young-nights/bluetooth_42_stepper_motor_balance_car/Diy-code_balance-car_ver1.0/docs/hardware-spec.md

# 42步进电机平衡车 — 硬件参数规格

> **项目**：Bluetooth 42 Stepper Motor Balance Car (蓝牙42步进电机平衡车)
>
> **版本**：Ver 1.0
>
> **文档日期**：2025-05-25

---

## 1. MCU 主控

| 参数 | 值 |
|---|-----|
| 型号 | STM32F103RCT6 |
| 内核 | ARM Cortex-M3 |
| 主频 | 72 MHz |
| Flash | 256 KB |
| SRAM | 48 KB |
| 封装 | LQFP64 |

---

## 2. IMU 惯性测量单元

| 参数 | 值 |
|---|-----|
| 型号 | MPU6050（InvenSense） |
| 通信接口 | I2C（软件模拟/硬件） |
| 姿态解算方法 | 互补滤波 |
| 滤波系数 α | 0.96（陀螺仪权重 96%，加速度计 4%） |
| 加速度计量程 | ±2g |
| 陀螺仪量程 | ±2000°/s |
| 姿态采样率 | 100 Hz（10ms 周期） |
| 俯仰角分辨率 | 0.01° |
| 机械中值 | 0.36° |

---

## 3. 电机

| 参数 | 值 |
|---|-----|
| 型号 | 42 步进电机 A0022 |
| 相数 | 2 相 |
| 步距角 | 1.8°（200 步/转） |
| 额定电压 | 3.0V |
| 额定电流 | 1.5A / 相 |
| 相电阻 | 2.0Ω（20°C） |
| 相电感 | 5.6mH（1kHz） |
| 保持力矩 | 0.40 N·m |
| 最大转速 | 800 RPM |
| 转子惯量 | 38 g·cm² |
| 重量 | 286.3g |
| 出轴直径 | 5mm |
| 机座尺寸 | NEMA17（42×42mm） |

---

## 4. 电机驱动

| 参数 | 值 |
|---|-----|
| 型号 | DRV8825（TI） |
| 工作模式 | 16 细分 + 混合衰减模式 |
| 最大驱动电流 | 2.5A / 相（峰值） |
| PWM 输出通道 | 左电机：TIM3_CH3 (PB0)；右电机：TIM3_CH4 (PB1) |
| PWM 频率 | 20 kHz |
| 使能引脚 | 通用 GPIO |
| 方向控制 | STEP/DIR 模式 |

---

## 5. 车轮

| 参数 | 值 |
|---|-----|
| 直径 | 65mm |
| 周长 | 204mm（π×65mm） |
| 材质 | 橡胶轮胎 |

---

## 6. 控制系统

| 参数 | 值 |
|---|-----|
| 控制架构 | 直立 PD + 速度 PI 串级控制 |
| 控制周期 | 5ms（200 Hz） |
| 姿态更新周期 | 10ms（100 Hz），MPU6050 数据读取 |
| 线程优先级 | 20 |
| 线程栈大小 | 4096 字节 |
| OS | RT-Thread v4.x |

---

## 7. PID 参数

| 控制环 | 参数 | 当前值 | 说明 |
|---|---|---|---|
| **直立环** | Kp | 15.0 | 比例增益 |
| | Ki | 0 | 不使用积分项 |
| | Kd | 4.0 | 微分阻尼（抑制高频振荡） |
| | 输出限幅 | ±1300 | 占空比限幅 |
| **速度环** | Kp | 0（已禁用） | 加速度计积分估算速度噪声过大 |
| | Ki | 0（已禁用） | 暂未启用，待编码器方案 |

> **注意**：速度环当前已禁用（Kp=0, Ki=0），因为速度估算基于 MPU6050 加速度计积分，
> 在无编码器的步进电机系统中，积分漂移噪声过大，会干扰直立环调试。
> 建议后续加装编码器后再重新启用速度环。

---

## 8. 蓝牙通信

| 参数 | 值 |
|---|-----|
| 模块接口 | UART2（115200bps，8N1） |
| 蓝牙模式 | SPP（串口透传） |
| UUID | 00001101-0000-1000-8000-00805F9B34FB |
| 设备名 | BalanceCar |
| 协议 | 自定义帧格式（Header 0x55AA / CRC16 Modbus） |

---

## 9. 电源

| 参数 | 值 |
|---|-----|
| 电池类型 | 锂电池组 |
| 电机供电 | 12V（经 DRV8825 直接驱动） |
| MCU 供电 | 3.3V（LDO 稳压） |
| MPU6050 供电 | 3.3V |

---

## 10. 机械参数

| 参数 | 值 |
|---|-----|
| 轴距（轮距） | ~150mm |
| 重心高度 | ~50mm（电池底部附近） |
| 总重量（含电池） | ~800g |

---

*文档维护：平衡车项目组 | 最后更新：2025-05-25*
