young-nights/bluetooth_42_stepper_motor_balance_car/2.Protolcal/通讯协议.docx

通讯协议

Balance Car

平衡小车

编制：xxx

版本号：V1.0

# 1 版本升级说明

版本号 | 变更原因
V1.0 | 首次编制

# 2 术语

MCU：指清洁洗脸仪。 APP：指手机端应用程序。

# 3 概述

通信以主/从方式为主，APP 作为通信主机，在需要时，发起一次通信。MCU 作为从机设备，收到主机命令后，执行相关动作或回应相关数据。当出现异常或其他情况时，MCU 也会主动上报一些信息给 APP 主机。

# 4 串口参数

波特率 | 数据位 | 奇偶校验 | 停止位
9600 bps | 8 位 | 无 | 1位

# 5 帧结构

帧头 | 帧数据 | | | | | | | | | | | | 校验码
| 长度 | | 数据
| | | 设备编号 | | 命令
| | | | | 命令类型 | | 命令状态 | | 命令编码 | | 参数列表
Head | | Length | | ID | | Type | | State | Code | Parameter | | CRC
2 Byte | | 1 Byte | | 2 Byte | | 1 Byte | | 1 Byte | 1 Byte | n Byte | | 2 Byte

Length覆盖区域 = ID + Type + State + Code + Parameter

CRC校验区域 = Length + ID +Type + State + Code + Parameter

## 帧头（Head）

固定为 0x55,0xAA。

## 数据长度（Length）

设备编号+命令的字节数。即：(ID + Type + State + Code + Parameter)的字节数。

## 设备编号（ID）

设备机型对应的 ID 编码。例如：Bcar-01 机型的 ID 编码为：0x00,0x73。

## 命令类型（Type）

命令类型包含三类：

0x31: 命令（动作）类，从机收到此类命令，通常执行某些动作。

0x32: 写数据（设置参数）类，从机收到此类命令，更新相关参数，如模式、强度档位等。

0x33: 读数据（读取参数、状态）类，从机收到此类命令，回应相关参数或状态信息。

0x66: 主动上报（异常）类，比如温度过高、NTC 异常、强度改变等。

## 命令状态（State）

用于指示传输/校验是否出错。 APP 下发时，此域填 0x02。

MCU 回传时，若传输/校验出错，此域填 0x00；否则填 0x01。

## 命令编码（Code）

不同机型，根据具体功能，各自定义具体的命令码，详见机型功能命令码表。

## 参数列表（Parameter）

不同命令码，可以具有不同长度的参数，多字节参数时，高位字节在前。详见机型功能命令码表。

## 校验码（CRC）

校验多项式：X16+X15+X2+1。除帧头外，其它字节全部参与校验。校验码高位在前，低位在后。

# 6 0x31命令码表

命令类型 | 命令 码 | 参数列表 | | | 说明
| | 字节 | | 范围
0x31 | 0x10 | \ | | \ | 控制小车：向前
| 55 AA 05 00 73 31 02 10 A9 4B
| 0x11 | \ | | \ | 控制小车：向后
| 55 AA 05 00 73 31 02 11 69 8A
| 0x12 | \ | | \ | 控制小车：左转
| 55 AA 05 00 73 31 02 12 68 CA
| 0x13 | \ | | \ | 控制小车：右转
| 55 AA 05 00 73 31 02 13 A8 0B
| 0x14 | \ | | \ | 控制小车：直立
| 55 AA 05 00 73 31 02 14 6A 4A
| 0x15 | \ | | \ | 控制小车:完全停止与启动
| 启动：55 AA 06 00 73 31 02 15 01 A7 18 停止：55 AA 06 00 73 31 02 15 00 67 D9
| 0x16 | 1 | 0x00~0xFF | | 目标速度设置：单位m/s
| 55 AA 06 00 73 31 02 16 xx CRC_H CRC_L
| 0x17 | 1 | 0~1 | | 六面校准总指令
| 开启校准：55 AA 06 00 73 31 02 17 01 C7 19 关闭校准：55 AA 06 00 73 31 02 17 00 07 D8
| 0x18 | \ | \ | | 六面校准-X正方向-朝下
| 55 AA 05 00 73 31 02 18 6F 4A
| 0x19 | \ | \ | | 六面校准-X负方向-朝下
| 55 AA 05 00 73 31 02 19 AF 8B
| 0x1A | \ | \ | | 六面校准-Y正方向-朝下
| 55 AA 05 00 73 31 02 1A AE CB
| 0x1B | \ | \ | | 六面校准-Y负方向-朝下
| 55 AA 05 00 73 31 02 1B 6E 0A
| 0x1C | \ | \ | | 六面校准-Z正方向-朝下
| 55 AA 05 00 73 31 02 1C AC 4B
| 0x1D | \ | \ | | 六面校准-Z负方向-朝下
| 55 AA 05 00 73 31 02 1D 6C 8A
| 0x1E | \ | \ | | 陀螺仪静态校准
| 55 AA 05 00 73 31 02 1E 6D CA
| 0x1F | 1 | 0~8 | | 每个校准完后由此发送校准完的提示给APP用于界面弹窗提示
| 未完成校准：55 AA 06 00 73 31 02 1F 00 C7 DF 已完成陀螺仪校准：55 AA 06 00 73 31 02 1F 01 07 1E 已完成x轴正-向下校准：55 AA 06 00 73 31 02 1F 02 06 5E 已完成x轴负-向下校准: 55 AA 06 00 73 31 02 1F 03 C6 9F 已完成y轴正-向下校准：55 AA 06 00 73 31 02 1F 04 04 DE 已完成y轴负-向下校准：55 AA 06 00 73 31 02 1F 05 C4 1F 已完成z轴正-向下校准: 55 AA 06 00 73 31 02 1F 06 C5 5F 已完成z轴负-向下校准：55 AA 06 00 73 31 02 1F 07 05 9E
| 0x20 | 1 | 0~2 | | 控制设置小车的行进模式
| 前进模式：55 AA 06 00 73 31 02 20 01 F7 07 后退模式：55 AA 06 00 73 31 02 20 02 F6 4F 默认模式：55 AA 06 00 73 31 02 20 00 37 CE

# 7 0x32命令码表

命令类型 | 命令 码 | 参数列表 | | 说明
| | 字节 | 范围
0x32

命令类型 | 命令 码 | 参数列表 | | | | 说明
| | 字节 | | | 范围
0x32

# 8 0x33命令码表

命令类型 | 命令 码 | 参数列表 | | 说明
| | 字节 | 范围
0x33 | 0xA0 | 2 | 0~65535 | 获取：小车的行进线速度
| 0xA1 | 2 | 0~65535 | 获取：小车的欧拉角数据（三轴）
| 0xA2 | \ | \ | 发送：小车的准备就绪指令

# 9 宏定义参数阐述

宏定义名称 | 名称说明 | 指令码
