young-nights/bluetooth_42_stepper_motor_balance_car/1.Schematic/SCH_BlanceCar-BLE.pdf

## SW9TS⁻¹¹⁰¹⁻C⁻W

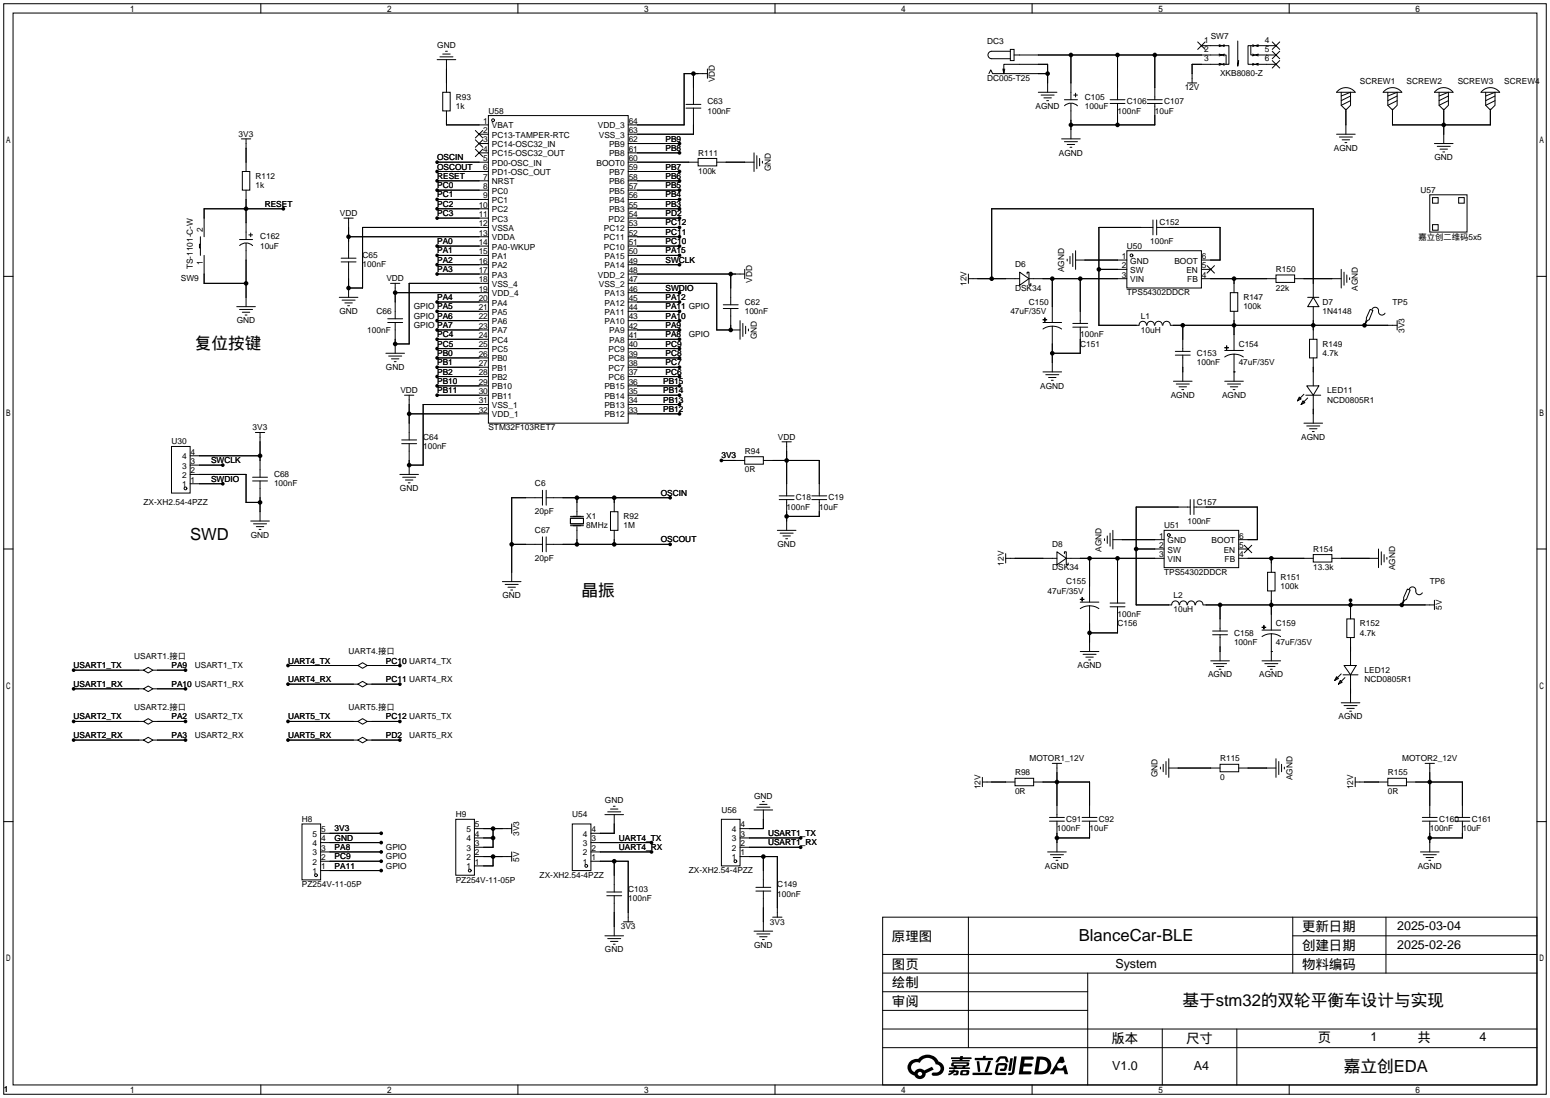
[picture p6: page 1]

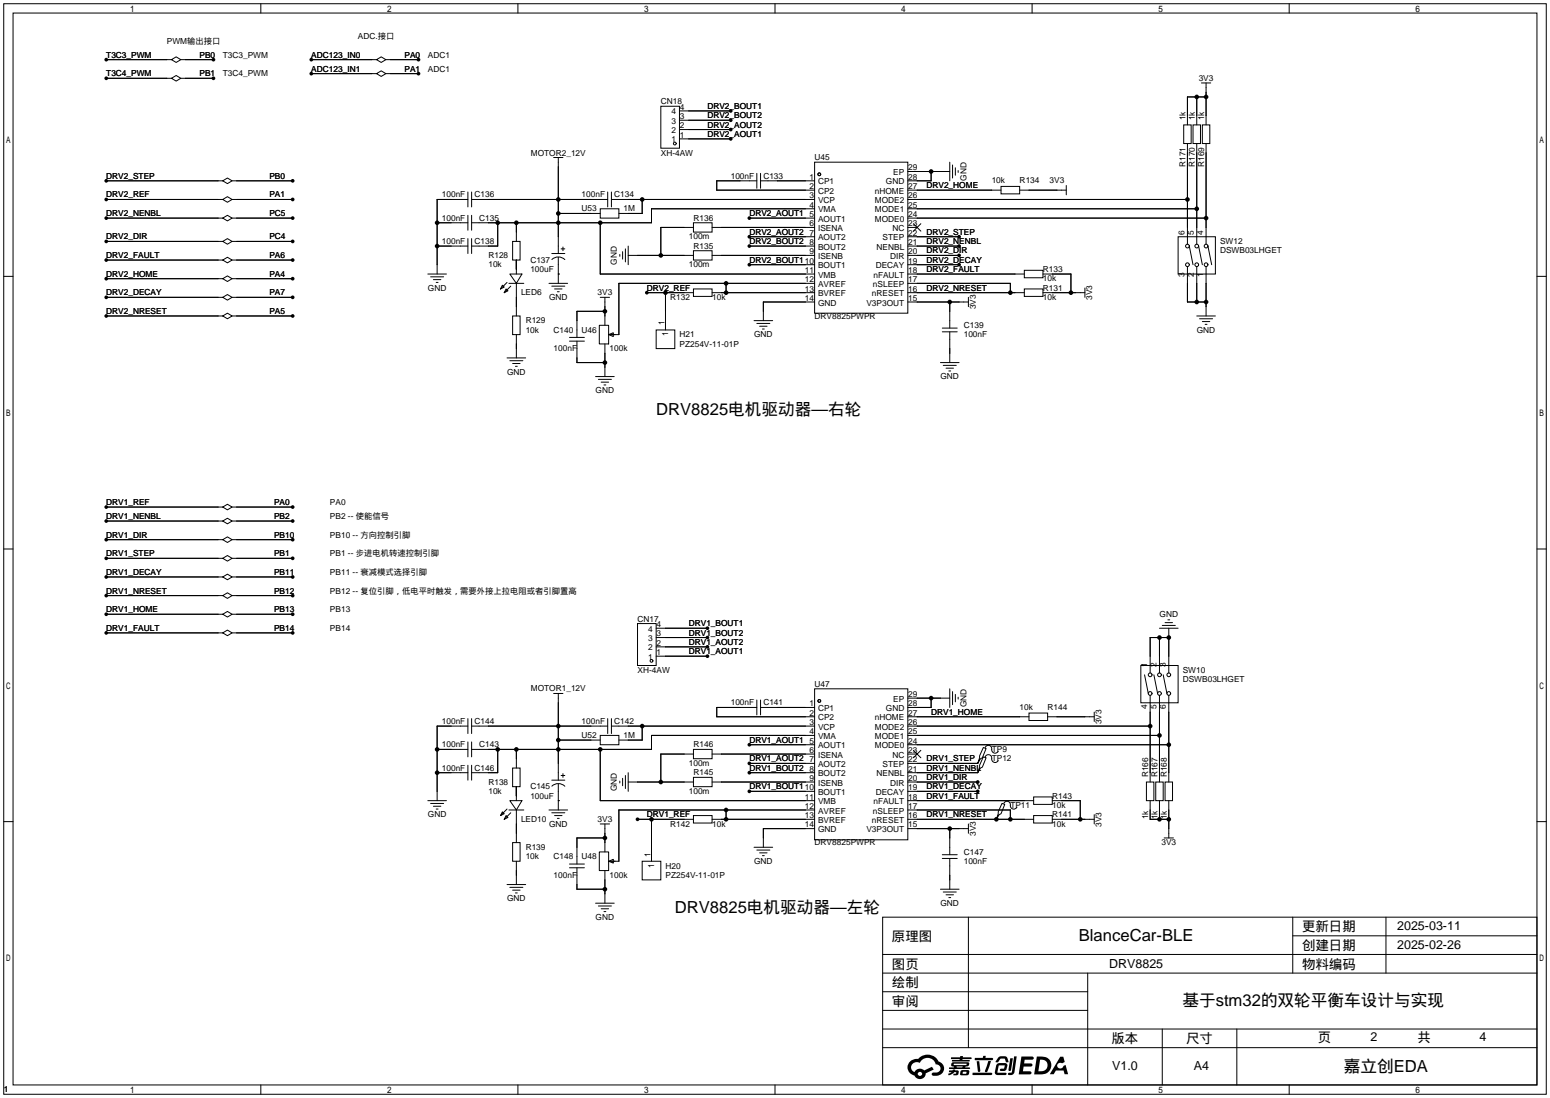
[picture p7: page 2]

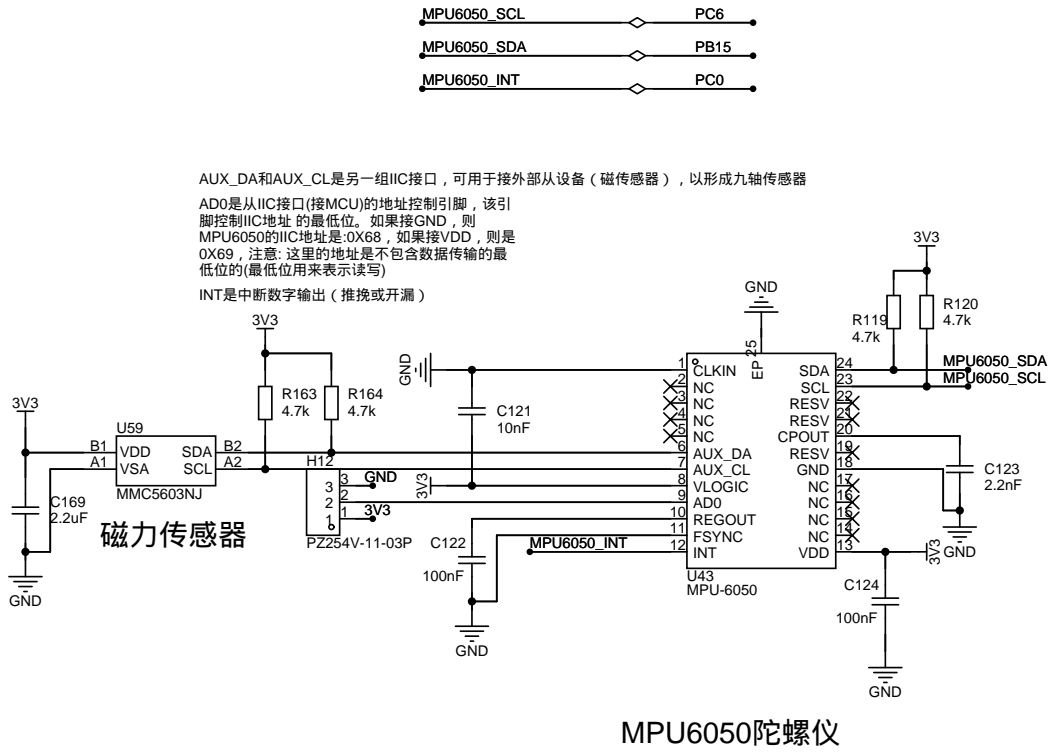
[picture p8: page 3]

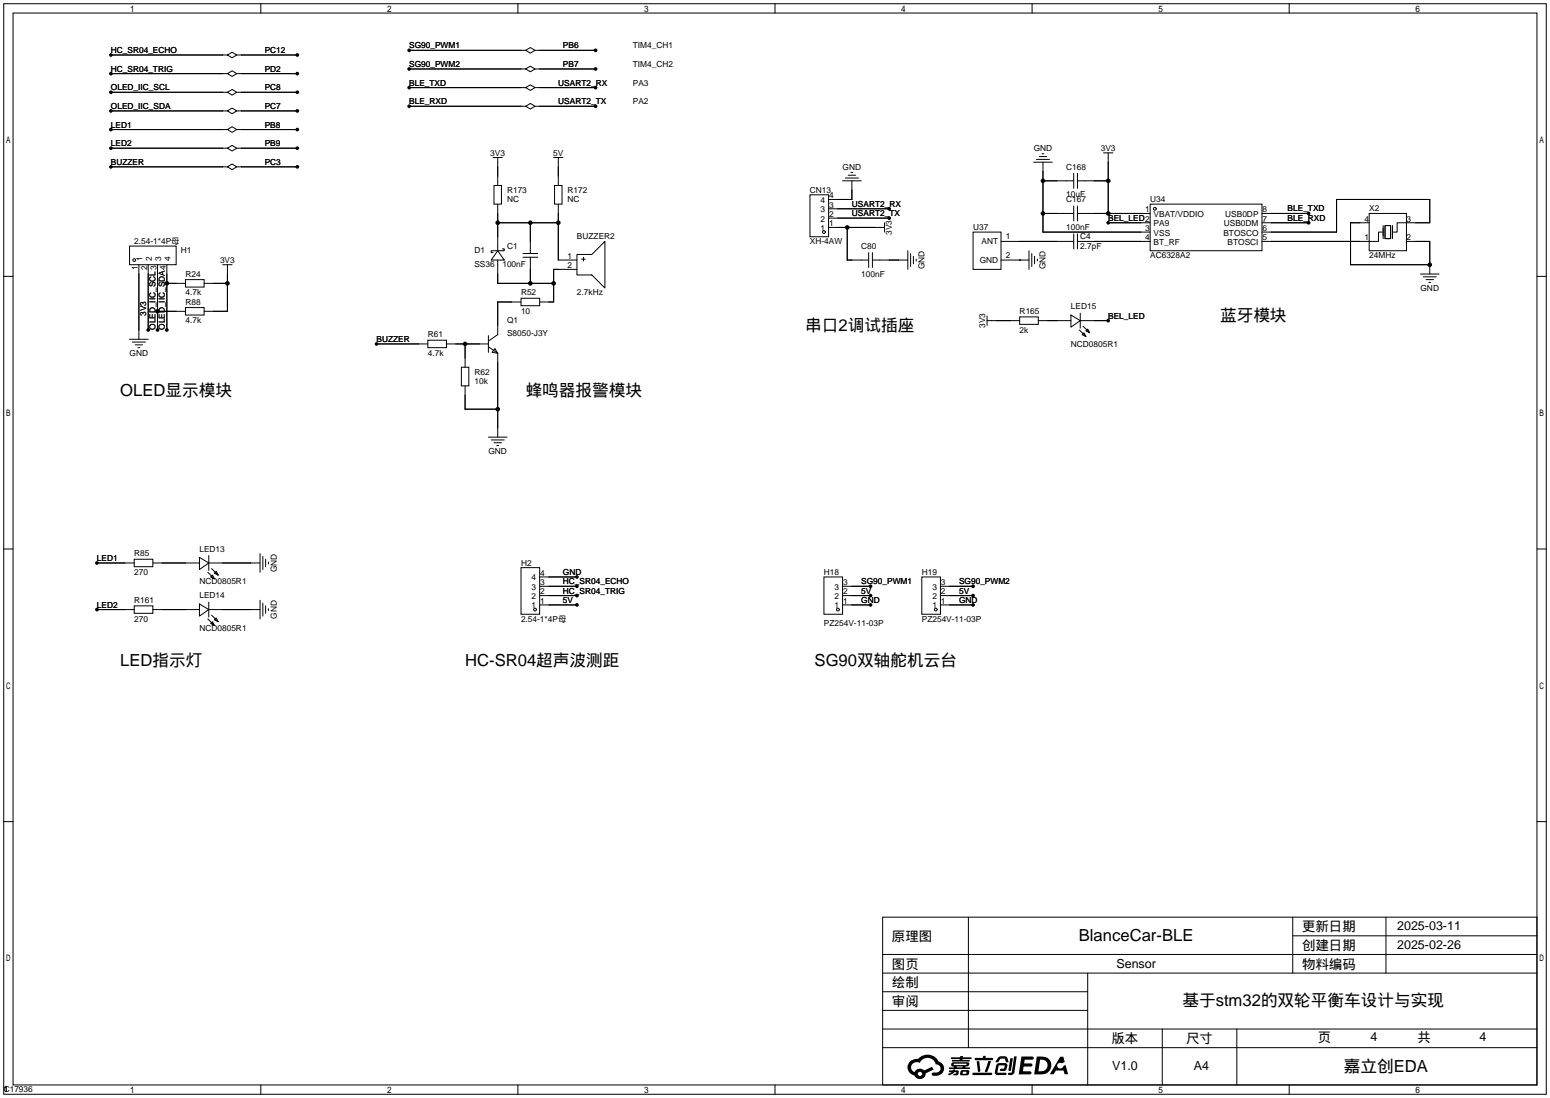
[picture p9: page 4]
