young-nights/bluetooth_42_stepper_motor_balance_car/Diy-code_balance-car_ver1.0/cubemx/Inc/main.h

#define BEEP_Pin GPIO_PIN_3
#define BEEP_GPIO_Port GPIOC
#define DRV1_VOL_REF_Pin GPIO_PIN_0
#define DRV1_VOL_REF_GPIO_Port GPIOA
#define DRV2_VOL_REF_Pin GPIO_PIN_1
#define DRV2_VOL_REF_GPIO_Port GPIOA
#define DRV2_HOME_Pin GPIO_PIN_4
#define DRV2_HOME_GPIO_Port GPIOA
#define DRV2_NRESET_Pin GPIO_PIN_5
#define DRV2_NRESET_GPIO_Port GPIOA
#define DRV2_FAULT_Pin GPIO_PIN_6
#define DRV2_FAULT_GPIO_Port GPIOA
#define DRV2_DIR_Pin GPIO_PIN_4
#define DRV2_DIR_GPIO_Port GPIOC
#define DRV2_ENABLE_Pin GPIO_PIN_5
#define DRV2_ENABLE_GPIO_Port GPIOC
#define DRV1_NEBALE_Pin GPIO_PIN_2
#define DRV1_NEBALE_GPIO_Port GPIOB
#define DRV1_DIR_Pin GPIO_PIN_10
#define DRV1_DIR_GPIO_Port GPIOB
#define DRV1_NRESET_Pin GPIO_PIN_12
#define DRV1_NRESET_GPIO_Port GPIOB
#define DRV1_HOME_Pin GPIO_PIN_13
#define DRV1_HOME_GPIO_Port GPIOB
#define DRV1_FAULT_Pin GPIO_PIN_14
#define DRV1_FAULT_GPIO_Port GPIOB
#define LED1_Pin GPIO_PIN_8
#define LED1_GPIO_Port GPIOB
#define LED2_Pin GPIO_PIN_9
#define LED2_GPIO_Port GPIOB
