young-nights/bluetooth_42_stepper_motor_balance_car/(commit log)

2026-05-23 feat: add complete balance car project with schematics, protocol docs, and code (23 optimizations applied)
    [kconfig-language.txt, kconfig.txt, 数据记录.xlsx]
2026-05-23 fix: resolve compilation errors - missing macConfig.h include, static function visibility, calibration return
    [bsp_mpu6050_calibration.c, rtt_motor_ctrl.c, rtt_motor_ctrl.h]
2026-05-24 feat: complete BLE car control app with full business logic and animations
    - Added BluetoothService singleton (device scan, connect, data send/receive, CRC16)
    - Rewrote SettingsActivity with BLE scanning and permission handling
    - Rewrote ControlActivity with jog direction control and toggle modes
    - Rewrote CalibrationActivity with attitude display and calibration commands
    - Optimized MainActivity with real-time data polling and display
    - Added activity transition animations (slide/fade)
    - Added button press feedback animations (scale + ripple)
    - Fixed navigation drawer default selected item
    - Fixed drawer-close-then-navigate to avoid transition stutter
2026-05-24 fix: eliminate ControlActivity transition stutter (layout inflation jank)
    - ControlActivity: defer listener setup to after first frame via getDecorView().post()
    The 15KB layout inflates ~30 views on the main thread; setting up listeners
    synchronously in onCreate adds extra work before the first frame renders,
    causing visible frame-drop during the slide-in animation.
    - Remove animateLayoutChanges from calibration/settings layouts (overhead reduction)
    - Simplify navigation code: startActivity immediately after drawer close
2026-05-24 refactor: make ControlActivity the home page, rename old home to Data Panel
    - ControlActivity is now the launcher (main) activity with navigation drawer
    - Added NavigationView sidebar to activity_control.xml
    - MainActivity simplified to data panel (no drawer, back button to ControlActivity)
    - Nav menu: 控制面板 first (home), 数据面板 second
    - All parentActivityName references updated to ControlActivity
    - Removed DrawerLayout from activity_main.xml (now simple data display)
2026-05-24 fix: three UI issues after refactor
    1. Direction buttons transparent: removed selectableItemBackgroundBorderless
    which renders invisible on some themes (buttons now use default style)
    2. Drawer selection not reset: added onResume() to ControlActivity that
    calls nav_view_control.setCheckedItem(R.id.nav_home) on return
    3. Calibration buttons text overflow: added autoSizeTextType=uniform
    + maxLines=1 to all three calibration buttons
2026-05-24 refactor: redesign data panel UI with modern card-based layout
    - Replaced old icon+label layout with colored CardView cards
    - Each data metric in a rounded card with colored background
    - Sections: Speed (real/normal blue+green), Distance (purple), Attitude (pitch/roll/yaw - orange/red/cyan)
    - ScrollView support for small screens
    - Updated MainActivity Java to match new view IDs and value-only display format
2026-05-25 fix: increase vertical PD Kd 0.1→4.0 to damp oscillation; disable speed loop PI; add hardware spec docs (zh/en)
    [rtt_motor_pid.c]
2026-05-25 feat: PID adaptive tuning with coordinate-descent gradient search
    - Add rtt_pid_autotune module with coordinate-descent algorithm
    - Optimize Kp and Kd alternately (3 rounds, 2s data per trial)
    - Cost function: J = RMS(angle_error) + 0.15 * RMS(gyro)
    - Safety: abort on angle > 35° or car picked up
    - Flash persistence at 0x0801F800 with magic+CRC validation
    - Bluetooth commands: 0x22 start, 0x23 stop, 0x24 load, 0x25 reset
    - Integrate into balance_car_thread_entry at 5ms control loop
    [rtt_motor_pid.c, rtt_motor_pid.h, rtt_pid_autotune.c, rtt_pid_autotune.h, rtt_uart2_Decode_Poll_Pattern.c, rtt_uart2_Decode_Poll_Pattern.h]
2026-05-25 fix: CRC check logic inverted in autotune_load_from_flash
    [rtt_pid_autotune.c]
