young-nights/bluetooth_42_stepper_motor_balance_car/(notices)

Notices in the files:
Diy-code_balance-car_ver1.0/cubemx/Inc/main.h:
Copyright (c) 2025 STMicroelectronics.
All rights reserved.
This software is licensed under terms that can be found in the LICENSE file
